svip48-hue/KAPO-Ta4ka/README.md

# KAPO-Ta4ka

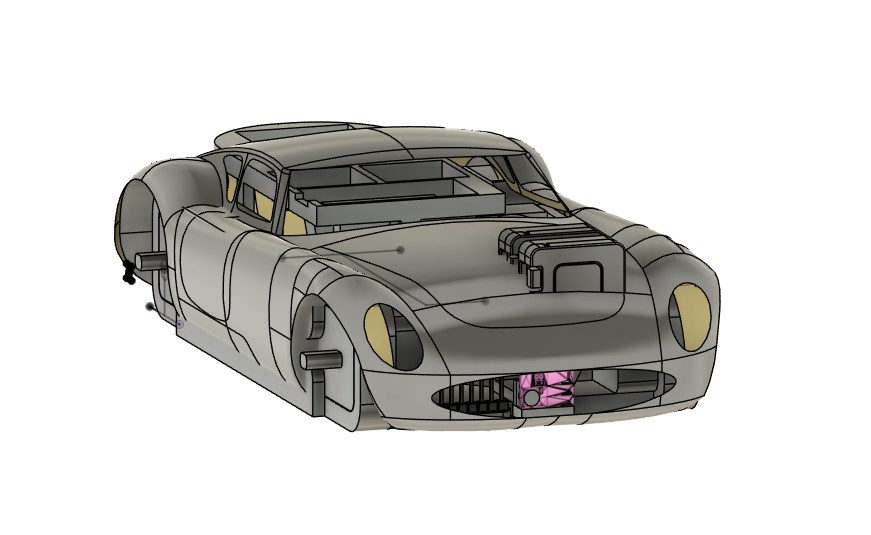
[picture p1: Screenshot_396.png]
Ta4ka
