svip48-hue/KAPO-Ta4ka/Verstapost 2/IMG_2742 (1).jpg

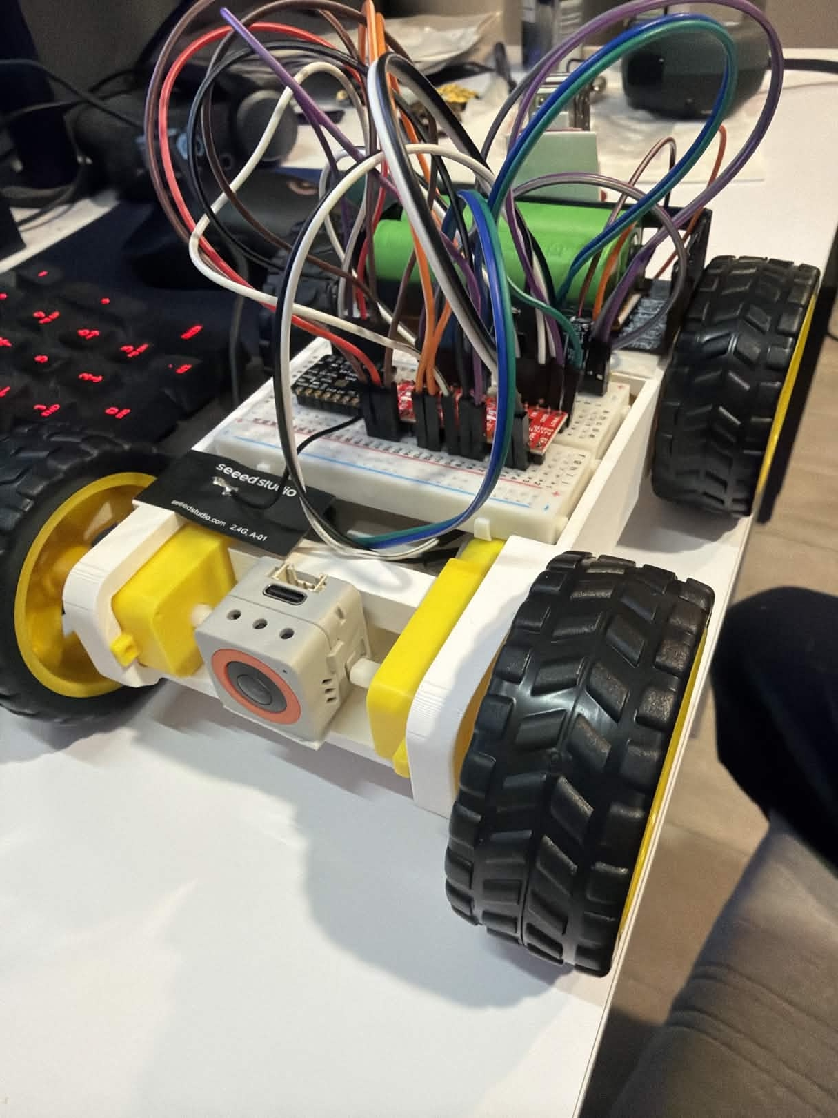
Verstapost 2/IMG_2742 (1).jpg
