svip48-hue/KAPO-Ta4ka/Verstapost 3/Image (15).jpg

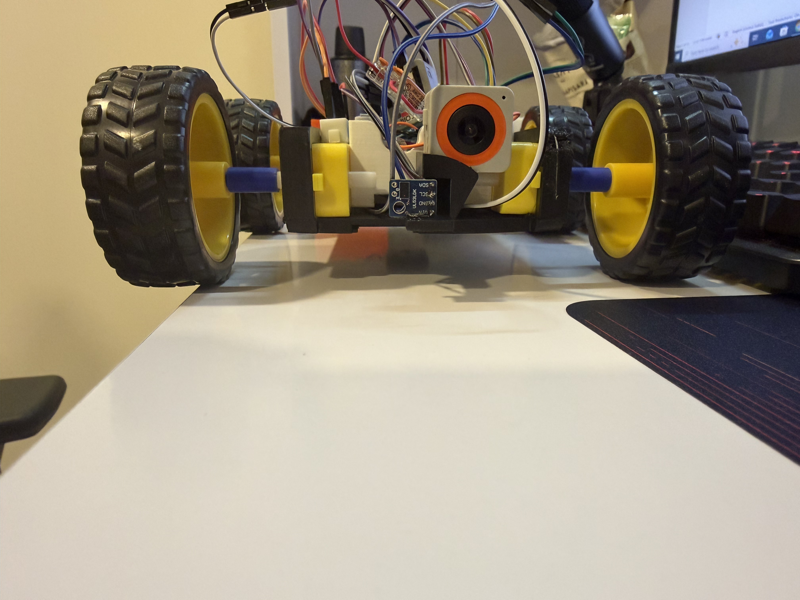
Verstapost 3/Image (15).jpg
