svip48-hue/KAPO-Ta4ka/(list of files, cad)

Other CAD files:
Verstapost 1/Fusion/4 motors 4 wheels same level.f3z
